Pilou44/master_system_converter/(list of files, drawings)

Other design files:
pcb/PCB_Master System Converter.json
