Pilou44/master_system_converter/(commit log)

2022-10-06 Upload PCB files
    [PCB_Master System Converter.json]
2022-10-06 Upload arduino code
2022-10-06 Update PCB
    [PCB_Master System Converter.json]
2022-10-25 Update PCB for version 1.1
    [PCB_Master System Converter.json]
2022-10-25 PCB routed with Freerouter
    [PCB_Master System Converter.json]
2022-11-14 Update design for version 1.2
    [PCB_Master System Converter.json]
